mathzieg/Split-Flap-Display/pcb/split_flap_unit/split_flap_unit.kicad_pcb

## KiCad design pcb/split_flap_unit/split_flap_unit.kicad_pcb (2026-04-30)

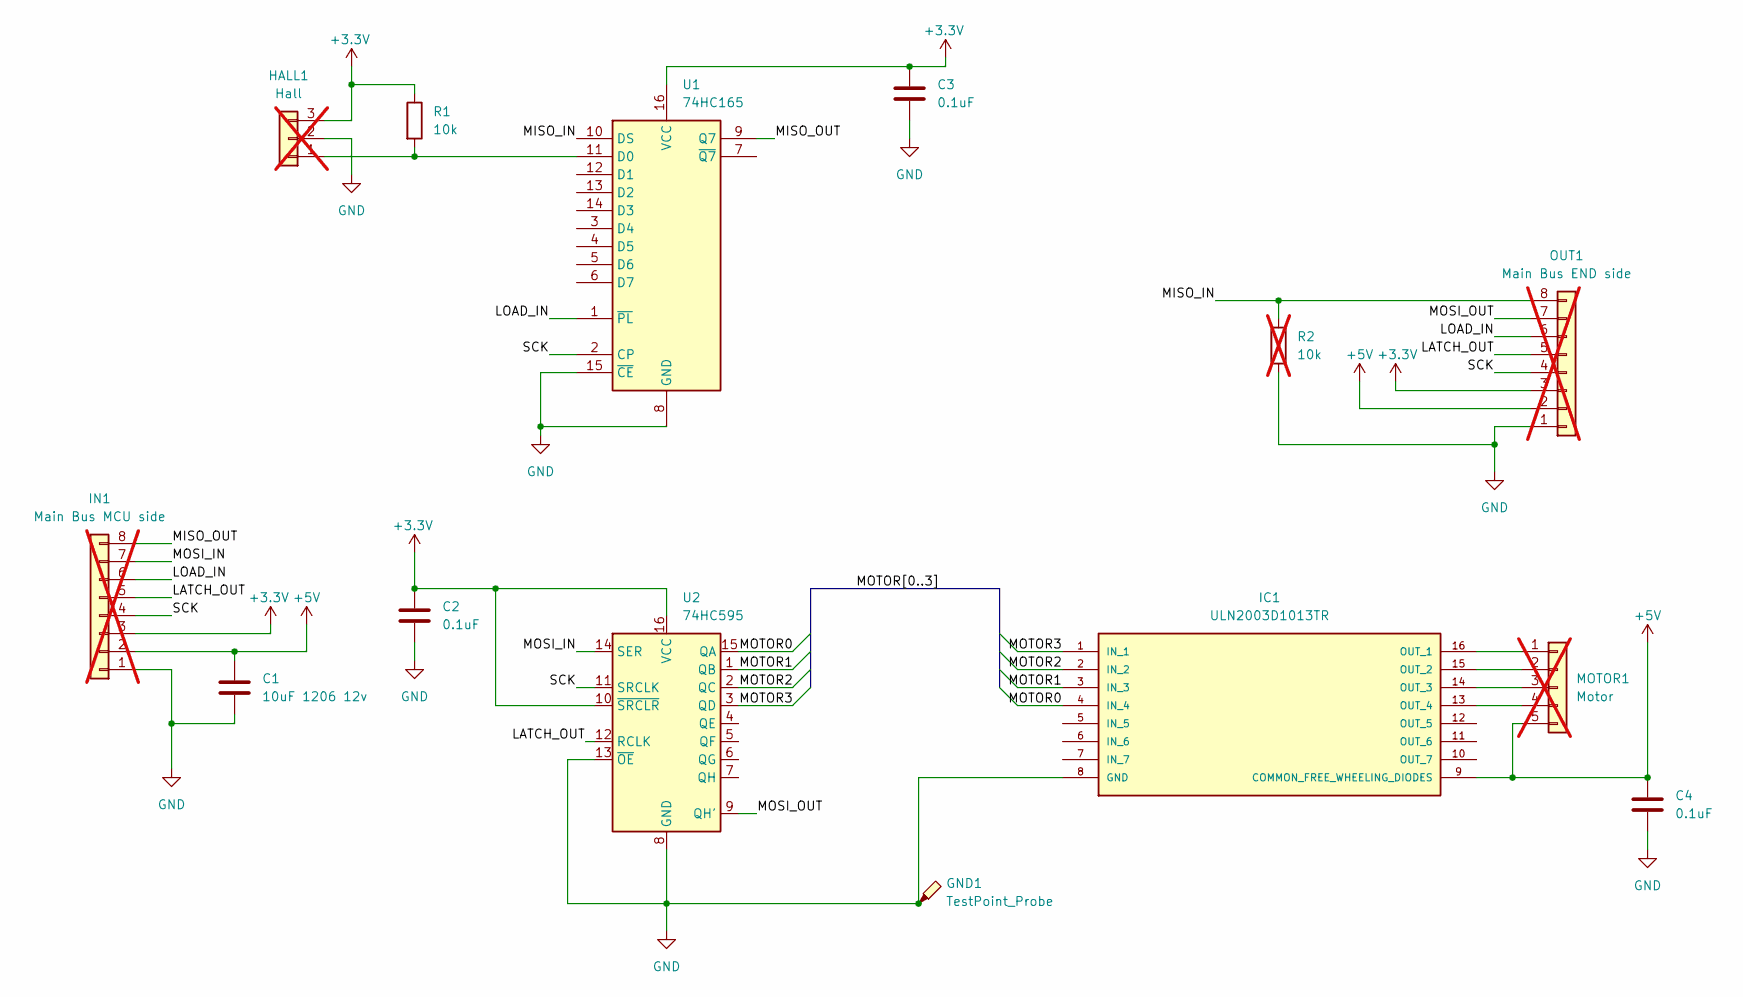
[picture p1: schematic split_flap_unit.kicad_sch]

Parts:
C1: 10uF 1206 12v; C_1206_3216Metric_Pad1.33x1.80mm_HandSolder
C2, C3, C4: 0.1uF; C_0805_2012Metric_Pad1.18x1.45mm_HandSolder
GND1: TestPoint_Probe; TestPoint_Pad_D2.0mm
HALL1: Hall; JST_XH_B3B-XH-AM_1x03_P2.50mm_Vertical; not fitted
IC1: ULN2003D1013TR; SOIC-16_3.9x9.9mm_P1.27mm; MOUSER_PART_NUMBER 511-ULN2003D1013TR
IN1: Main Bus MCU side; PinHeader_1x08_P2.54mm_Horizontal; not fitted
MOTOR1: Motor; JST_XH_B5B-XH-AM_1x05_P2.50mm_Vertical; not fitted
OUT1: Main Bus END side; PinSocket_1x08_P2.54mm_Horizontal; not fitted
R1: 10k; R_0805_2012Metric_Pad1.20x1.40mm_HandSolder
R2: 10k; R_0805_2012Metric_Pad1.20x1.40mm_HandSolder; not fitted
U1: 74HC165; SOIC-16_3.9x9.9mm_P1.27mm
U2: 74HC595; SOIC-16_3.9x9.9mm_P1.27mm

Connections:
+3.3V: C2.1, C3.1, HALL1.3, IN1.3, OUT1.3, R1.1, U1.16 (VCC), U2.10 (~SRCLR), U2.16 (VCC)
+5V: C1.1, C4.1, IC1.9 (COMMON_FREE_WHEELING_DIODES), IN1.2, MOTOR1.5, OUT1.2
/LATCH_OUT: IN1.5, OUT1.5, U2.12 (RCLK)
/LOAD_IN: IN1.6, OUT1.6, U1.1 (~PL)
/MISO_IN: OUT1.8, R2.1, U1.10 (DS)
/MISO_OUT: IN1.8, U1.9 (Q7)
/MOSI_IN: IN1.7, U2.14 (SER)
/MOSI_OUT: OUT1.7, U2.9 (QH')
/MOTOR0: IC1.4 (IN_4), U2.15 (QA)
/MOTOR1: IC1.3 (IN_3), U2.1 (QB)
/MOTOR2: IC1.2 (IN_2), U2.2 (QC)
/MOTOR3: IC1.1 (IN_1), U2.3 (QD)
/SCK: IN1.4, OUT1.4, U1.2 (CP), U2.11 (SRCLK)
GND: C1.2, C2.2, C3.2, C4.2, GND1.1 (1_1), HALL1.2, IC1.8 (GND), IN1.1, OUT1.1, R2.2, U1.8 (GND), U1.15 (~CE), U2.8 (GND), U2.13 (~OE)
unnamed: HALL1.1, R1.2, U1.11 (D0)
unnamed: IC1.16 (OUT_1), MOTOR1.1
unnamed: IC1.15 (OUT_2), MOTOR1.2
unnamed: IC1.14 (OUT_3), MOTOR1.3
unnamed: IC1.13 (OUT_4), MOTOR1.4

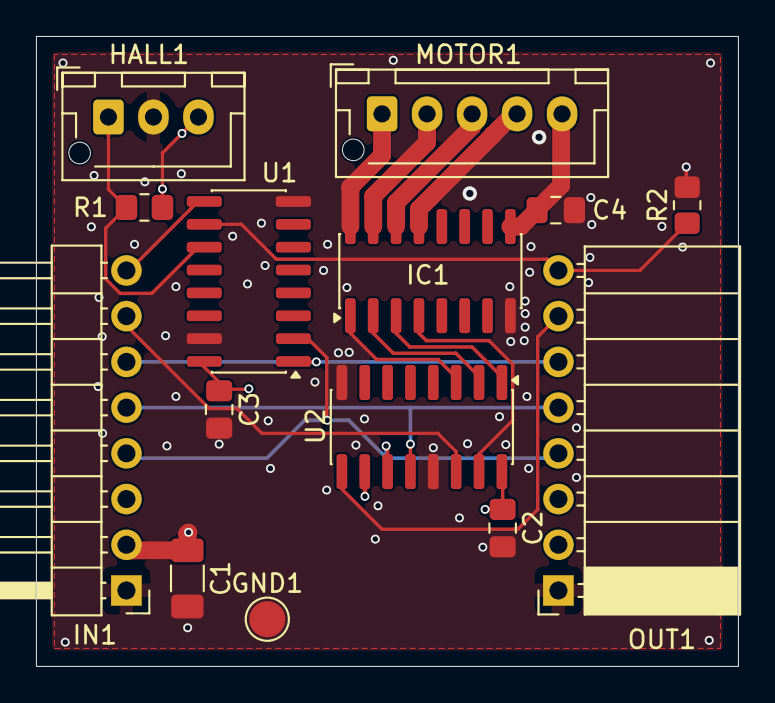
[picture p2: board split_flap_unit.kicad_pcb from above]

Board: 4 copper layers, 39.0 x 35.0 mm, 14 parts (0 on the bottom side), 19 nets.
