mathzieg/Split-Flap-Display/src/SplitFlapDisplay.cpp

#include "SplitFlapDisplay.h"

#include "JsonSettings.h"
#include "SplitFlapModule.h"
#include "SplitFlapMqtt.h"

SplitFlapDisplay::SplitFlapDisplay(JsonSettings &settings) : settings(settings) {}

void SplitFlapDisplay::init() {
    // --- SPI SETUP ---
    pinMode(latchOutPin, OUTPUT);
    pinMode(latchInPin, OUTPUT);
    digitalWrite(latchOutPin, HIGH);
    digitalWrite(latchInPin, HIGH);
    SPI.begin(4, 5, 6, -1); // SCK=4, MISO=5, MOSI=6, SS not used (-1)

    numModules = settings.getInt("moduleCount");
    stepsPerRot = settings.getInt("stepsPerRot");
    displayOffset = settings.getInt("displayOffset");
    magnetPosition = settings.getInt("magnetPosition");
    maxVel = settings.getFloat("maxVel");
    charSetSize = settings.getInt("charset");

    std::vector<int> settingOffsets = settings.getIntVector("moduleOffsets");
    for (int i = 0; i < numModules; i++) {
        moduleOffsets[i] = settingOffsets[i];
    }

    Serial.print("Module Offsets: ");
    for (int i = 0; i < numModules; i++) {
        Serial.print(moduleOffsets[i]);
        Serial.print(" ");
    }
    Serial.println();

    for (uint8_t i = 0; i < numModules; i++) {
        // FIX: Removed 'moduleAddresses[i]' since SPI daisy-chains don't use individual addresses
        modules[i] = SplitFlapModule(
            stepsPerRot, moduleOffsets[i] + displayOffset, magnetPosition, charSetSize
        );
    }

    // FIX: Removed the Wire.begin() I2C setup, it is no longer needed!

    for (uint8_t i = 0; i < numModules; i++) {
        modules[i].init();
    }
}

void SplitFlapDisplay::testAll() {
    char testChars[37] = {' ', 'A', 'B', 'C', 'D', 'E', 'F', 'G', 'H', 'I', 'J', 'K', 'L', 'M', 'N', 'O', 'P', 'Q', 'R',
                          'S', 'T', 'U', 'V', 'W', 'X', 'Y', 'Z', '0', '1', '2', '3', '4', '5', '6', '7', '8', '9'};
    int numChars = sizeof(testChars) / sizeof(testChars[0]);
    int targetPositions[numModules];

    int charPos;
    for (int i = 0; i < numChars; i++) {
        // Serial.print("Target Positions: [");
        // fill array with same char

        for (int j = 0; j < numModules; j++) {
            targetPositions[j] = modules[j].getCharPosition(testChars[i]);
            // Serial.print(targetPositions[j]);
            // Serial.print(" , ");
        }
        // Serial.println("]");

        moveTo(targetPositions);
        delay(500);
    }
}

void SplitFlapDisplay::testRandom(float speed) {
    char testChars[37] = {' ', 'A', 'B', 'C', 'D', 'E', 'F', 'G', 'H', 'I', 'J', 'K', 'L', 'M', 'N', 'O', 'P', 'Q', 'R',
                          'S', 'T', 'U', 'V', 'W', 'X', 'Y', 'Z', '0', '1', '2', '3', '4', '5', '6', '7', '8', '9'};

    int targetPositions[numModules];
    char randChar;

    Serial.print("Target: ");
    for (int i = 0; i < numModules; i++) {
        randChar = testChars[random(0, 37)];
        targetPositions[i] = modules[i].getCharPosition(randChar);
        Serial.print(randChar);
    }
    Serial.println(" ");
    moveTo(targetPositions, speed);
}

void SplitFlapDisplay::testCount() {
    int count = 0;
    int maxCount = pow(10, numModules);
    char targetChar;
    int targetInteger;

    int targetPositions[numModules];

    for (int i = 0; i < maxCount; i++) {
        // get each character in the count integer
        for (int j = 0; j < numModules; j++) {
            targetInteger = (i % (int) pow(10, j + 1)) / (int) pow(10, j);
            targetChar = targetInteger + '0'; // convert to char
            targetPositions[numModules - j - 1] = modules[j].getCharPosition(targetChar);
        }

        moveTo(targetPositions);
        delay(250);
    }
}

void SplitFlapDisplay::home(float speed) {
    Serial.println("Homing");
    int targetPositions[numModules];
    for (int i = 0; i < numModules; i++) {
        targetPositions[i] = (modules[i].getPosition() - 1 + stepsPerRot) % stepsPerRot;
    }
    startMotors();
    moveTo(targetPositions, speed, false);
    char homeChar = ' ';
    int charPosition;
    for (int i = 0; i < numModules; i++) {
        targetPositions[i] = modules[i].getCharPosition(homeChar);
    }
    moveTo(targetPositions, speed);
}

void SplitFlapDisplay::homeToString(String homeString, float speed, bool centering) {
    Serial.println("Homing");
    int targetPositions[numModules];
    for (int i = 0; i < numModules; i++) {
        targetPositions[i] = (modules[i].getPosition() - 1 + stepsPerRot) % stepsPerRot;
    }
    startMotors();
    moveTo(targetPositions, speed, false);
    writeString(homeString, speed, centering);
}

void SplitFlapDisplay::homeToChar(char homeChar, float speed) {
    Serial.println("Homing");
    int targetPositions[numModules];
    for (int i = 0; i < numModules; i++) {
        targetPositions[i] = (modules[i].getPosition() - 1 + stepsPerRot) % stepsPerRot;
    }
    startMotors();
    moveTo(targetPositions, speed, false);

    for (int i = 0; i < numModules; i++) {
        targetPositions[i] = modules[i].getCharPosition(homeChar);
    }
    moveTo(targetPositions, true, speed);
}

void SplitFlapDisplay::writeChar(char inputChar, float speed) {
    int targetPositions[numModules];
    // Iterate through the input string and process each character
    for (int i = 0; i < numModules; i++) {
        targetPositions[i] = modules[i].getCharPosition(inputChar);
    }
    moveTo(targetPositions, speed);
}

void SplitFlapDisplay::writeString(String inputString, float speed, bool centering) {
    String displayString = inputString.substring(0, numModules);

    if (centering) {
        int totalPadding = numModules - displayString.length();
        int paddingLeft = totalPadding / 2;
        int paddingRight = totalPadding - paddingLeft;

        // Add padding to the left
        String result = "";
        for (int i = 0; i < paddingLeft; i++) {
            result += " ";
        }

        // Add the original string
        result += displayString;

        // Add padding to the right
        for (int i = 0; i < paddingRight; i++) {
            result += " ";
        }
        displayString = result;
    } else {                                          // pad blanks to end, if no centering
        while (displayString.length() < numModules) { // Pad with spaces
            displayString += " ";                     // Padding with space
        }
    }

    int targetPositions[numModules];
    // Iterate through the input string and process each character
    for (int i = 0; i < displayString.length(); i++) {
        char currentChar = displayString[i];
        // Serial.println(currentChar);
        targetPositions[i] = modules[i].getCharPosition(currentChar);
    }
    moveTo(targetPositions, speed);

    if (mqtt && mqtt->isConnected()) {
        mqtt->publishState(displayString);
    }
}

void SplitFlapDisplay::moveTo(int targetPositions[], float speed, bool releaseMotors) {
    // TODO check length of array and return if empty

    speed = constrain(speed, 2, maxVel);
    float stepsPerSecond = (speed / 60) * stepsPerRot;
    float timePerStep = 1000000 / stepsPerSecond;

    unsigned long currentTime = micros();

    int checkIntervalUs = 20 * 1000; // How often to check each modules hall effect sensor, less
    // than 20ms causes issues with bouncing
    int startStopDelay = 200; // time to wait to let motor realign itself to
    // magnetic field on stop and start

    bool resetLatches[numModules] = {}; // Initialize to false //start with latch on to prevent case where the
    // motion starts with the magnet over the sensor
    bool needsStepping[numModules] = {};             // Initialize to false; //modules that still require moving
    unsigned long lastStepTimes[numModules] = {};    // Initialize to false; //track when each module was last stepped
    unsigned long lastSensorCheckTime = currentTime; // track when we last read all the hall effect sensors

    for (int i = 0; i < numModules; i++) {
        targetPositions[i] = constrain(
            targetPositions[i],
            0,
            stepsPerRot - 1
        ); // Constrain to avoid errors with incorrect inputs
        resetLatches[i] = true;
        lastStepTimes[i] = currentTime;
        if (modules[i].getPosition() != targetPositions[i]) {
            needsStepping[i] = true;
        } else {
            needsStepping[i] = false;
        }
    }

    startMotors(); 
    updateShiftRegisters(); // <-- NEW: Push the initial coil activation states to the 595s
    delay(startStopDelay);  // give the motor time to align to magnetic field

    bool isFinished = checkAllFalse(needsStepping, numModules);
    while (! isFinished) {
        currentTime = micros();
        bool didAnyStep = false; // <-- NEW: Track if we need to push data via SPI

        for (int i = 0; i < numModules; i++) {
            if (((currentTime - lastStepTimes[i]) > timePerStep) && needsStepping[i]) {
                modules[i].step();
                lastStepTimes[i] = micros();
                didAnyStep = true; // <-- NEW: Flag that motor state memory was updated

                if (modules[i].getPosition() == targetPositions[i]) { 
                    // this module is not in the correct position, requires stepping
                    needsStepping[i] = false;
                }
            }
        }

        // <-- NEW: If any motor stepped in memory, push the new states to the 595s
        if (didAnyStep) {
            updateShiftRegisters();
        }

        if ((currentTime - lastSensorCheckTime) > checkIntervalUs) { // check hall effect sensor every checkIntervalMs
            
            // <-- NEW: Read all 74HC165 inputs at once
            readShiftRegisters();


            // check every modules sensor
            for (int i = 0; i < numModules; i++) {
                
                // <-- NEW: Pass the pre-read SPI byte to the module instead of doing an I2C read
                if (needsStepping[i] && modules[i].isMagnetDetected(sr_inputs[i])) { 
                    
                    if (! resetLatches[i]) {

                        Serial.print("Module "); Serial.print(i); 
                        Serial.print(" detected magnet at step: "); Serial.println(modules[i].getPosition());

                        modules[i].magnetDetected(); // update position to the modules magnet position
                        resetLatches[i] = true;

                    }
                } else if (resetLatches[i] == true) {
                    resetLatches[i] = false;
                }
            }
            isFinished = checkAllFalse(needsStepping, numModules);
            lastSensorCheckTime = currentTime; // recall micros because for loop may take a moment to execute
        }
    }
    if (releaseMotors) {
        delay(startStopDelay); // allow all motors time to settle
        stopMotors();
        updateShiftRegisters(); // <-- NEW: Push the final "all off" states to the 595s
    }
}
bool SplitFlapDisplay::checkAllFalse(bool array[], int size) {
    for (int i = 0; i < size; i++) {
        if (array[i] == true) {
            return false;              // As soon as a true value is found, return false
        }
    }
    return true;                       // All values were false
}

void SplitFlapDisplay::startMotors() { // Probably broken somewhere, not sure
    // why, haven't looked
    for (int i = 0; i < numModules; i++) {
        modules[i].start();
    }
}

void SplitFlapDisplay::stopMotors() {
    // Serial.println("Stopping Motors");
    for (int i = 0; i < numModules; i++) {
        modules[i].stop();
    }
}

void SplitFlapDisplay::setMqtt(SplitFlapMqtt *mqttHandler) {
    mqtt = mqttHandler;
}


void SplitFlapDisplay::updateShiftRegisters() {
    digitalWrite(latchOutPin, LOW);
    
    // Shift out data. The last module in the chain needs to be sent FIRST.
    for (int i = numModules - 1; i >= 0; i--) {
        SPI.transfer(modules[i].getMotorState());
    }
    
    digitalWrite(latchOutPin, HIGH);
}

void SplitFlapDisplay::readShiftRegisters() {
    // Pulse the load pin to capture inputs into the 74HC165
    digitalWrite(latchInPin, LOW);
    delayMicroseconds(5); 
    digitalWrite(latchInPin, HIGH);

    // Read in data. The module closest to the ESP outputs its data FIRST.
    for (int i = 0; i < numModules; i++) {
        sr_inputs[i] = SPI.transfer(0x00);
    }
}
