mathzieg/Split-Flap-Display/(commit log)

2026-04-08 updated for spi
2026-04-10 Changed spi pin
2026-04-13 added the pcbs
    [BOM-split_flap_unit.csv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]
2026-04-30 added thermal relief on main pcb and corrected an error
    [BOM-split_flap_unit.csv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]
2026-04-30 Added text on pcb
    [split_flap_unit.kicad_pcb, split_flap_unit.kicad_sch]
